polygon/nrfled/nrflpc.brd

## EAGLE design nrflpc.brd (2013-02-13)

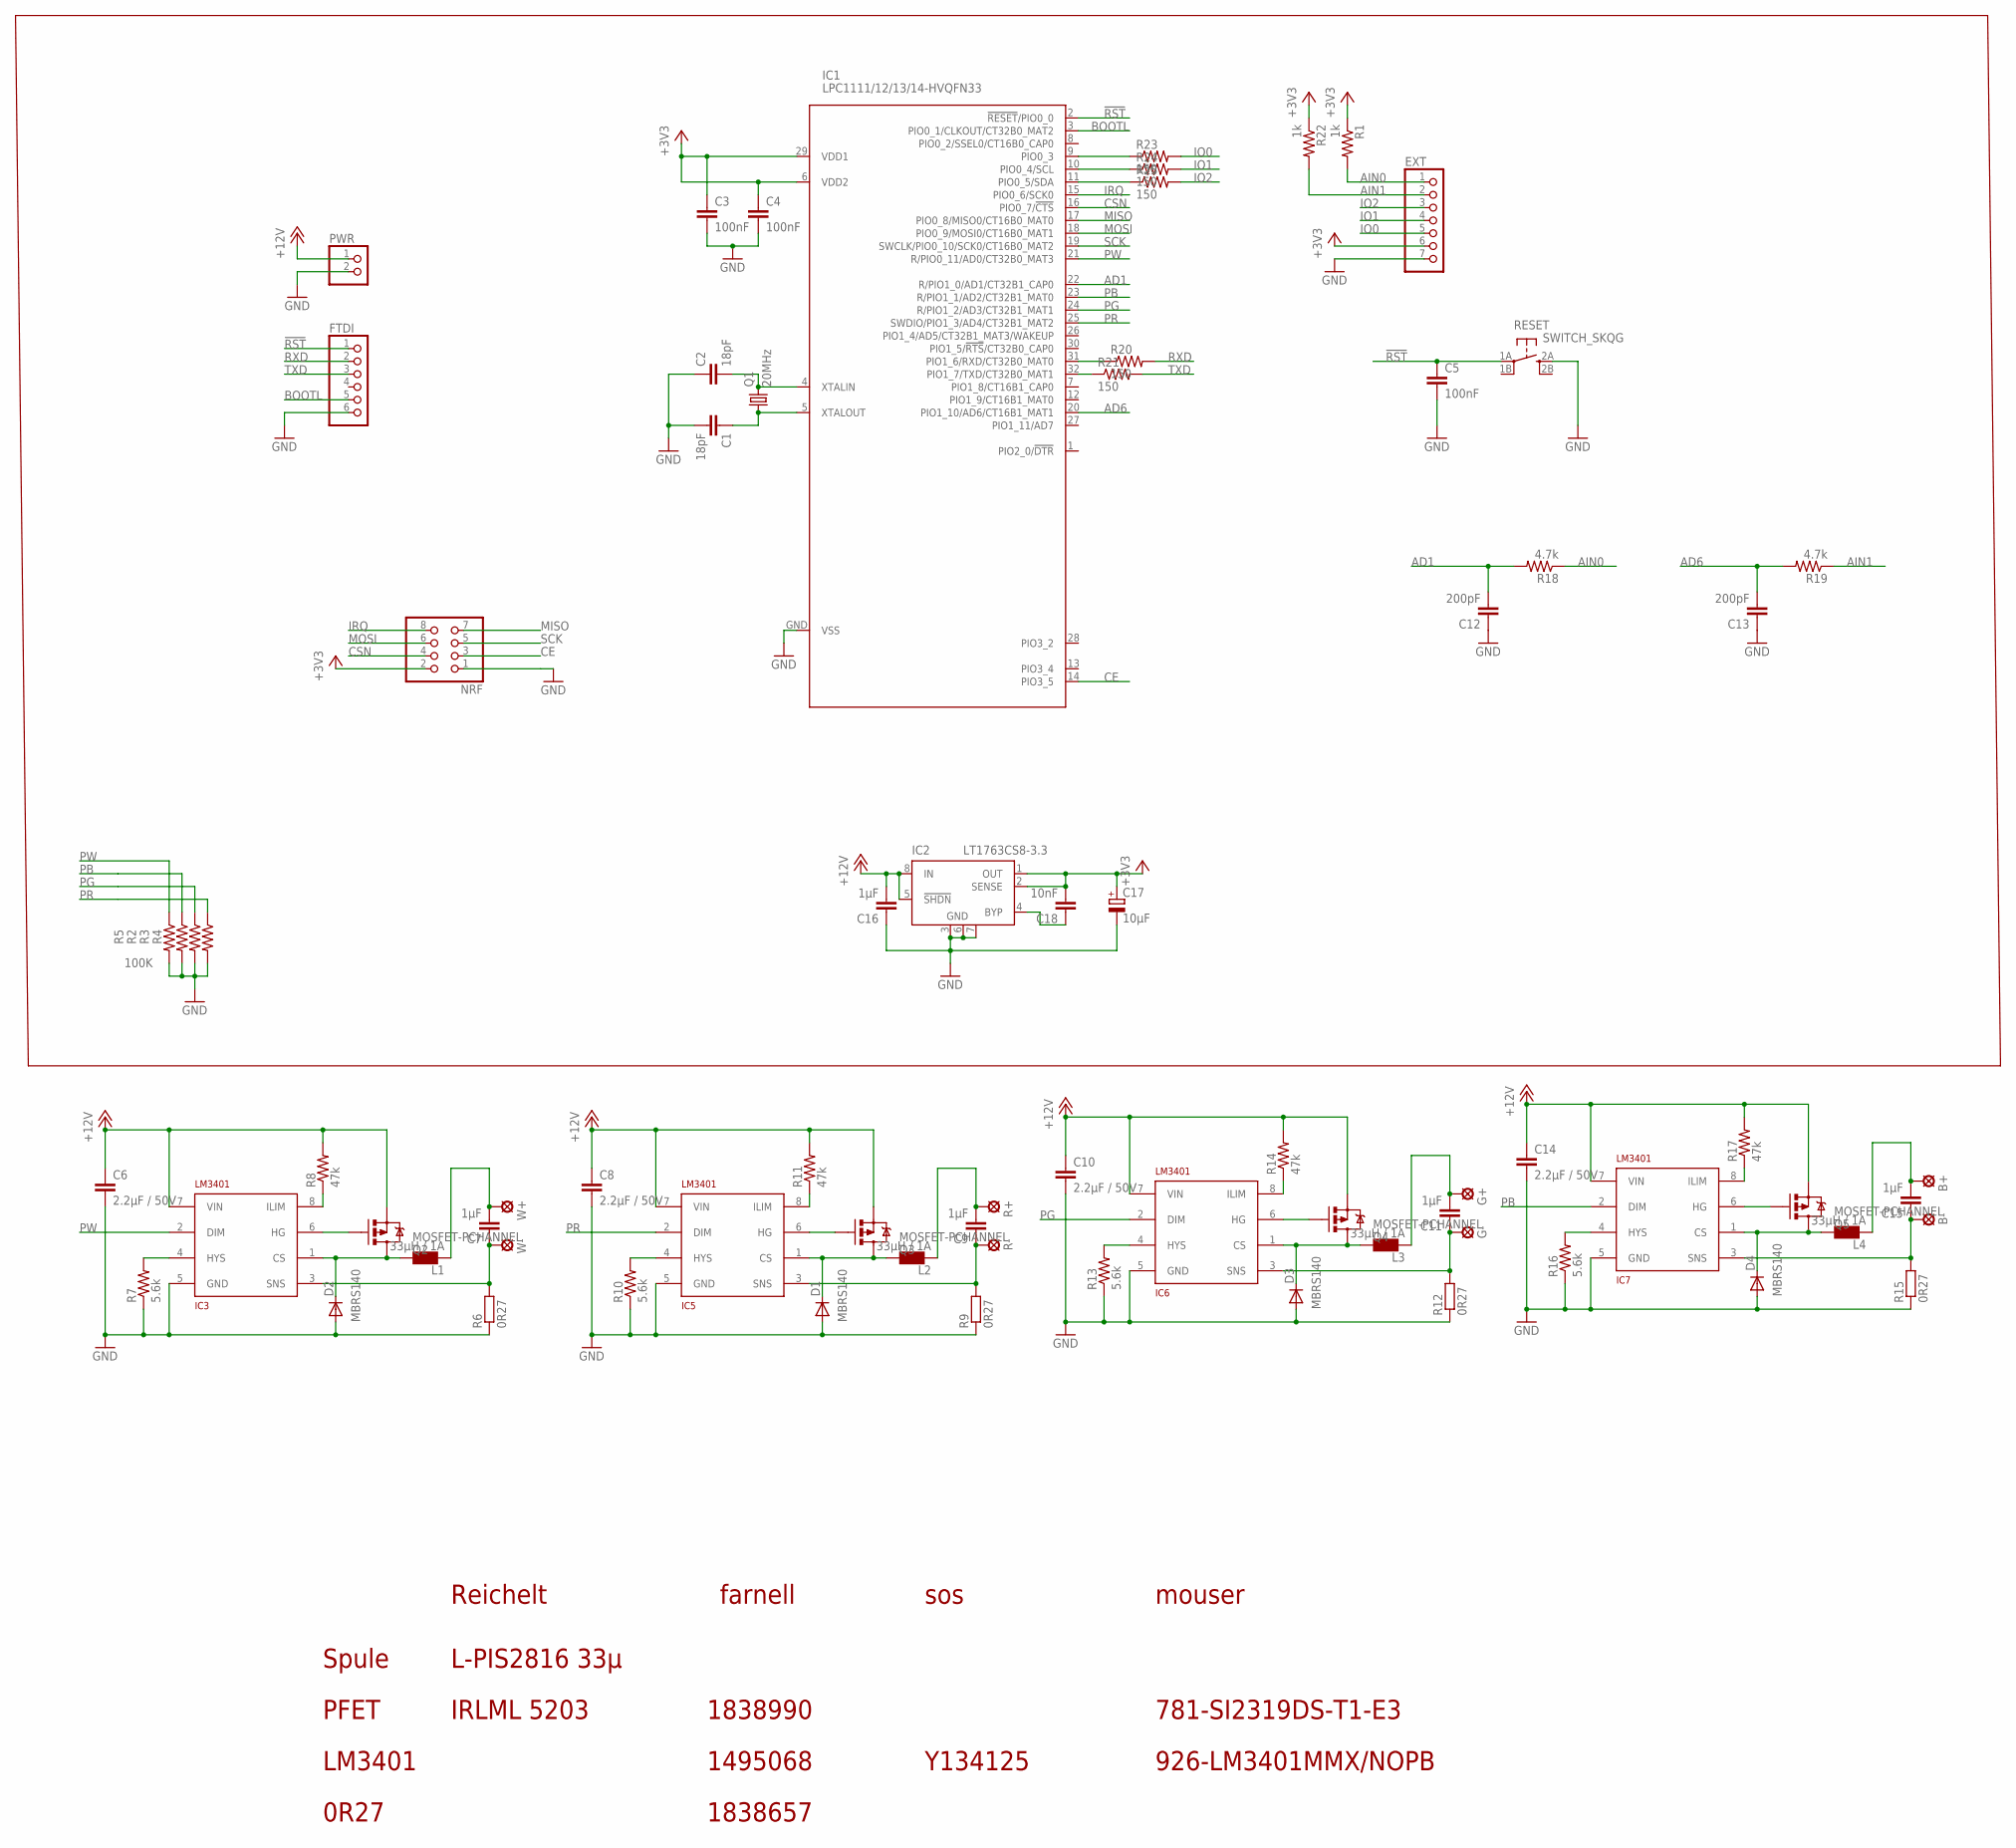
[picture p1: schematic nrflpc.sch]

Parts:
B+: SE14
B-: SE14
C1, C2: 18pF; 0402-CAP
C3, C4, C5: 100nF; 0402-CAP
C6, C8, C10, C14: 2.2µF / 50V; C1210
C7, C9, C11, C15, C16: 1µF; 0805
C12, C13: 200pF; 0402-CAP
C17: 10µF; SMC_A
C18: 10nF; 0402-CAP
D1, D2, D3, D4: MBRS140; SMB
EXT: PINHD-1X7; 1X07
FTDI: PINHD-1X6; 1X06
G+: SE14
G-: SE14
IC1: LPC1111/12/13/14-HVQFN33; HVQFN33
IC2: LT1763CS8-3.3; SOIC8
IC3, IC5, IC6, IC7: LM3401; MSOP8
L1, L2, L3, L4: 33µH / 1A; PIS2816
NRF: PINHD-2X4; 2X04
PWR: PINHD-1X2; 1X02
Q1: 20MHz; MT
Q2, Q3, Q4, Q5: MOSFET-PCHANNEL; SOT23
R1, R22: 1k; 0402-RES
R2, R3, R4, R5: 100K; 0402-RES
R6, R9, R12, R15: 0R27; R1206
R7, R10, R13, R16: 5.6k; 0805
R8, R11, R14, R17: 47k; 0805
R18, R19: 4.7k; 0402-RES
R20, R21, R23, R24, R25: 150; 0402-RES
R+: SE14
R-: SE14
RESET: SWITCH_SKQG
W+: SE14
W-: SE14

Connections:
!RST: C5.1, FTDI.1, IC1.2 (!RESET!/PIO0_0), RESET.1A
+3V3: C3.1, C4.1, C17.+, C18.2, EXT.6, IC1.6 (VDD2), IC1.29 (VDD1), IC2.1 (OUT), IC2.2 (SENSE), NRF.2, R1.1, R22.1
+12V: C6.1, C8.1, C10.1, C14.1, C16.2, IC2.5 (!SHDN), IC2.8 (IN), IC3.7 (VIN), IC5.7 (VIN), IC6.7 (VIN), IC7.7 (VIN), PWR.1, Q2.2 (S), Q3.2 (S), Q4.2 (S), Q5.2 (S), R8.2, R11.2, R14.2, R17.2
AD1: C12.2, IC1.22 (R/PIO1_0/AD1/CT32B1_CAP0), R18.2
AD6: C13.2, IC1.20 (PIO1_10/AD6/CT16B1_MAT1), R19.2
AIN0: EXT.1, R1.2, R18.1
AIN1: EXT.2, R19.1, R22.2
BOOTL: FTDI.5, IC1.3 (PIO0_1/CLKOUT/CT32B0_MAT2)
CE: IC1.14 (PIO3_5), NRF.3
CSN: IC1.16 (PIO0_7/!CTS!), NRF.4
GND: C1.2, C2.1, C3.2, C4.2, C5.2, C6.2, C8.2, C10.2, C12.1, C13.1, C14.2, C16.1, C17.-, D1.A, D2.A, D3.A, D4.A, EXT.7, FTDI.6, IC1.GND (VSS), IC2.3 (GND), IC2.6 (GND), IC2.7 (GND), IC3.5 (GND), IC5.5 (GND), IC6.5 (GND), IC7.5 (GND), NRF.1, PWR.2, R2.2, R3.2, R4.2, R5.2, R6.1, R7.1, R9.1, R10.1, R12.1, R13.1, R15.1, R16.1, RESET.2A
IO0: EXT.5, R23.2
IO1: EXT.4, R24.2
IO2: EXT.3, R25.2
IRQ: IC1.15 (PIO0_6/SCK0), NRF.8
MISO: IC1.17 (PIO0_8/MISO0/CT16B0_MAT0), NRF.7
MOSI: IC1.18 (PIO0_9/MOSI0/CT16B0_MAT1), NRF.6
unnamed: C7.1, IC3.3 (SNS), R6.2, W-.MP
unnamed: C7.2, L1.P$2 (2), W+.MP
unnamed: D2.C, IC3.1 (CS), L1.P$1 (1), Q2.3 (D)
unnamed: C9.1, IC5.3 (SNS), R9.2, R-.MP
unnamed: IC3.4 (HYS), R7.2
unnamed: C9.2, L2.P$2 (2), R+.MP
unnamed: IC3.8 (ILIM), R8.1
unnamed: D1.C, IC5.1 (CS), L2.P$1 (1), Q3.3 (D)
unnamed: IC5.4 (HYS), R10.2
unnamed: IC3.6 (HG), Q2.1 (G)
unnamed: IC5.8 (ILIM), R11.1
unnamed: IC5.6 (HG), Q3.1 (G)
unnamed: C11.1, G-.MP, IC6.3 (SNS), R12.2
unnamed: C11.2, G+.MP, L3.P$2 (2)
unnamed: D3.C, IC6.1 (CS), L3.P$1 (1), Q4.3 (D)
unnamed: IC6.4 (HYS), R13.2
unnamed: IC6.8 (ILIM), R14.1
unnamed: C18.1, IC2.4 (BYP)
unnamed: C2.2, IC1.4 (XTALIN), Q1.3 (2)
unnamed: IC6.6 (HG), Q4.1 (G)
unnamed: B-.MP, C15.1, IC7.3 (SNS), R15.2
unnamed: B+.MP, C15.2, L4.P$2 (2)
unnamed: D4.C, IC7.1 (CS), L4.P$1 (1), Q5.3 (D)
unnamed: IC7.4 (HYS), R16.2
unnamed: IC7.8 (ILIM), R17.1
unnamed: IC7.6 (HG), Q5.1 (G)
unnamed: IC1.31 (PIO1_6/RXD/CT32B0_MAT0), R20.1
unnamed: C1.1, IC1.5 (XTALOUT), Q1.1
unnamed: IC1.32 (PIO1_7/TXD/CT32B0_MAT1), R21.1
unnamed: IC1.9 (PIO0_3), R23.1
unnamed: IC1.10 (PIO0_4/SCL), R24.1
unnamed: IC1.11 (PIO0_5/SDA), R25.1
PB: IC1.23 (R/PIO1_1/AD2/CT32B1_MAT0), IC7.2 (DIM), R2.1
PG: IC1.24 (R/PIO1_2/AD3/CT32B1_MAT1), IC6.2 (DIM), R3.1
PR: IC1.25 (SWDIO/PIO1_3/AD4/CT32B1_MAT2), IC5.2 (DIM), R4.1
PW: IC1.21 (R/PIO0_11/AD0/CT32B0_MAT3), IC3.2 (DIM), R5.1
RXD: FTDI.2, R20.2
SCK: IC1.19 (SWCLK/PIO0_10/SCK0/CT16B0_MAT2), NRF.5
TXD: FTDI.3, R21.2

Notes on the sheet:
Reichelt
Spule
L-PIS2816 33µ
PFET
LM3401
farnell
0R27
1838990
1838657
1495068
Y134125
sos
mouser
781-SI2319DS-T1-E3
926-LM3401MMX/NOPB
IRLML 5203

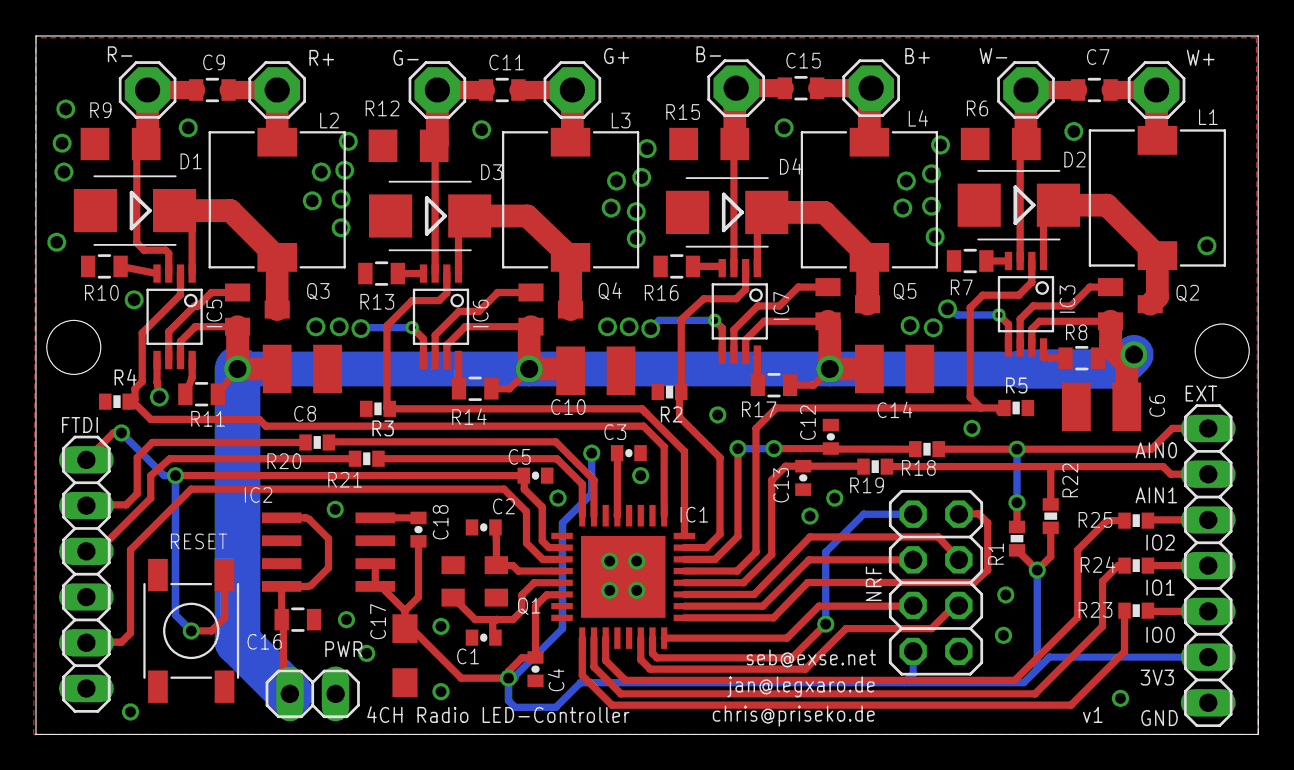
[picture p2: board nrflpc.brd from above]

Board: 2 copper layers, 67.9 x 38.8 mm, 75 parts (0 on the bottom side), 56 nets.
