polygon/nrfled/nrfctl.brd

## EAGLE design nrfctl.brd (2013-01-21)

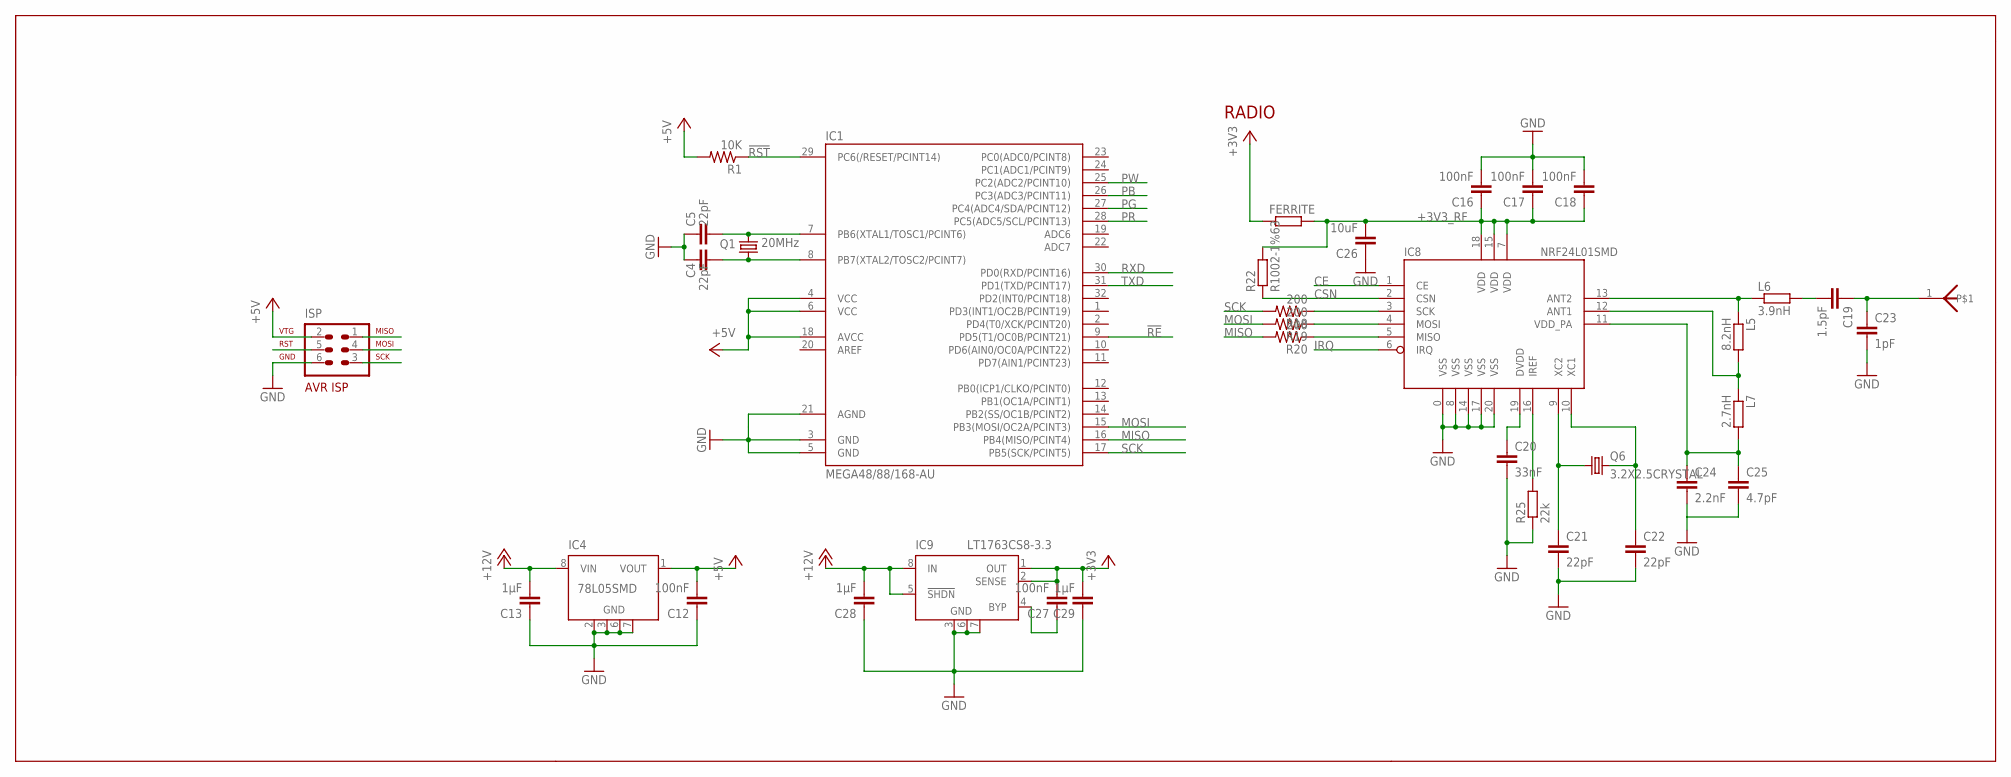
[picture p3: schematic nrfctl.sch]

Parts:
ANT: CHIPANTENNA
C4, C5: 22pF; 0402-CAP
C12, C27: 100nF; 0402-CAP
C13, C28, C29: 1µF; 0805
C16, C17, C18: 100nF; C0402K
C19: 1.5pF; C0402K
C20: 33nF; C0402K
C21, C22: 22pF; C0402K
C23: 1pF; C0402K
C24: 2.2nF; C0402K
C25: 4.7pF; C0402K
C26: 10uF; C0805K
FERRITE: R-EU_R0805; R0805
IC1: MEGA48/88/168-AU; TQFP32-08
IC4: 78L05SMD; SO08
IC8: NRF24L01SMD; QFN20
IC9: LT1763CS8-3.3; SOIC8
ISP: AVR-ISP-6
L5: 8.2nH; R0402
L6: 3.9nH; R0402
L7: 2.7nH; R0402
Q1: 20MHz; X22
Q6: 3.2X2.5CRYSTAL; CRYSTAL3.2X2.5
R1: 10K; 0402-RES
R18, R19, R20: 200; 0402-RES
R22: R1002-1%63; R0603
R25: 22k; R0603

Connections:
!RE: IC1.9 (PD5(T1/OC0B/PCINT21))
!RST: IC1.29 (PC6(/RESET/PCINT14)), ISP.5, R1.1
+3V3: C27.2, C29.2, FERRITE.1, IC9.1 (OUT), IC9.2 (SENSE)
+3V3_RF: C16.1, C17.1, C18.1, C26.2, FERRITE.2, IC8.7 (VDD), IC8.15 (VDD), IC8.18 (VDD), R22.2
+5V: C12.2, IC1.4 (VCC), IC1.6 (VCC), IC1.18 (AVCC), IC4.1 (VOUT), ISP.2, R1.2
+12V: C13.2, C28.2, IC4.8 (VIN), IC9.5 (!SHDN), IC9.8 (IN)
CE: IC8.1 (CE)
CSN: IC8.2 (CSN), R22.1
GND: C4.1, C5.1, C12.1, C13.1, C16.2, C17.2, C18.2, C20.2, C21.2, C22.2, C23.2, C24.2, C25.2, C26.1, C28.1, C29.1, IC1.3 (GND), IC1.5 (GND), IC1.21 (AGND), IC4.2 (GND), IC4.3 (GND), IC4.6 (GND), IC4.7 (GND), IC8.0 (VSS), IC8.8 (VSS), IC8.14 (VSS), IC8.17 (VSS), IC8.20 (VSS), IC9.3 (GND), IC9.6 (GND), IC9.7 (GND), ISP.6, R25.1
IRQ: IC8.6 (IRQ)
MISO: IC1.16 (PB4(MISO/PCINT4)), IC8.5 (MISO), ISP.1, R20.1, R20.2
MOSI: IC1.15 (PB3(MOSI/OC2A/PCINT3)), IC8.4 (MOSI), ISP.4, R19.1, R19.2
unnamed: C21.1, IC8.9 (XC2), Q6.1
unnamed: C22.1, IC8.10 (XC1), Q6.3 (2)
unnamed: ANT.1, C19.1, C23.1
unnamed: C27.1, IC9.4 (BYP)
unnamed: C20.1, IC8.19 (DVDD)
unnamed: IC8.16 (IREF), R25.2
unnamed: C24.1, C25.1, IC8.11 (VDD_PA), L7.2
unnamed: IC8.12 (ANT1), L5.2, L7.1
unnamed: IC8.13 (ANT2), L5.1, L6.1
unnamed: C19.2, L6.2
PB: IC1.26 (PC3(ADC3/PCINT11))
PG: IC1.27 (PC4(ADC4/SDA/PCINT12))
PR: IC1.28 (PC5(ADC5/SCL/PCINT13))
PW: IC1.25 (PC2(ADC2/PCINT10))
RXD: IC1.30 (PD0(RXD/PCINT16))
SCK: IC1.17 (PB5(SCK/PCINT5)), IC8.3 (SCK), ISP.3, R18.1, R18.2
TXD: IC1.31 (PD1(TXD/PCINT17))
XTAL1: C5.2, IC1.7 (PB6(XTAL1/TOSC1/PCINT6)), Q1.3 (2)
XTAL2: C4.2, IC1.8 (PB7(XTAL2/TOSC2/PCINT7)), Q1.1

Notes on the sheet:
RADIO

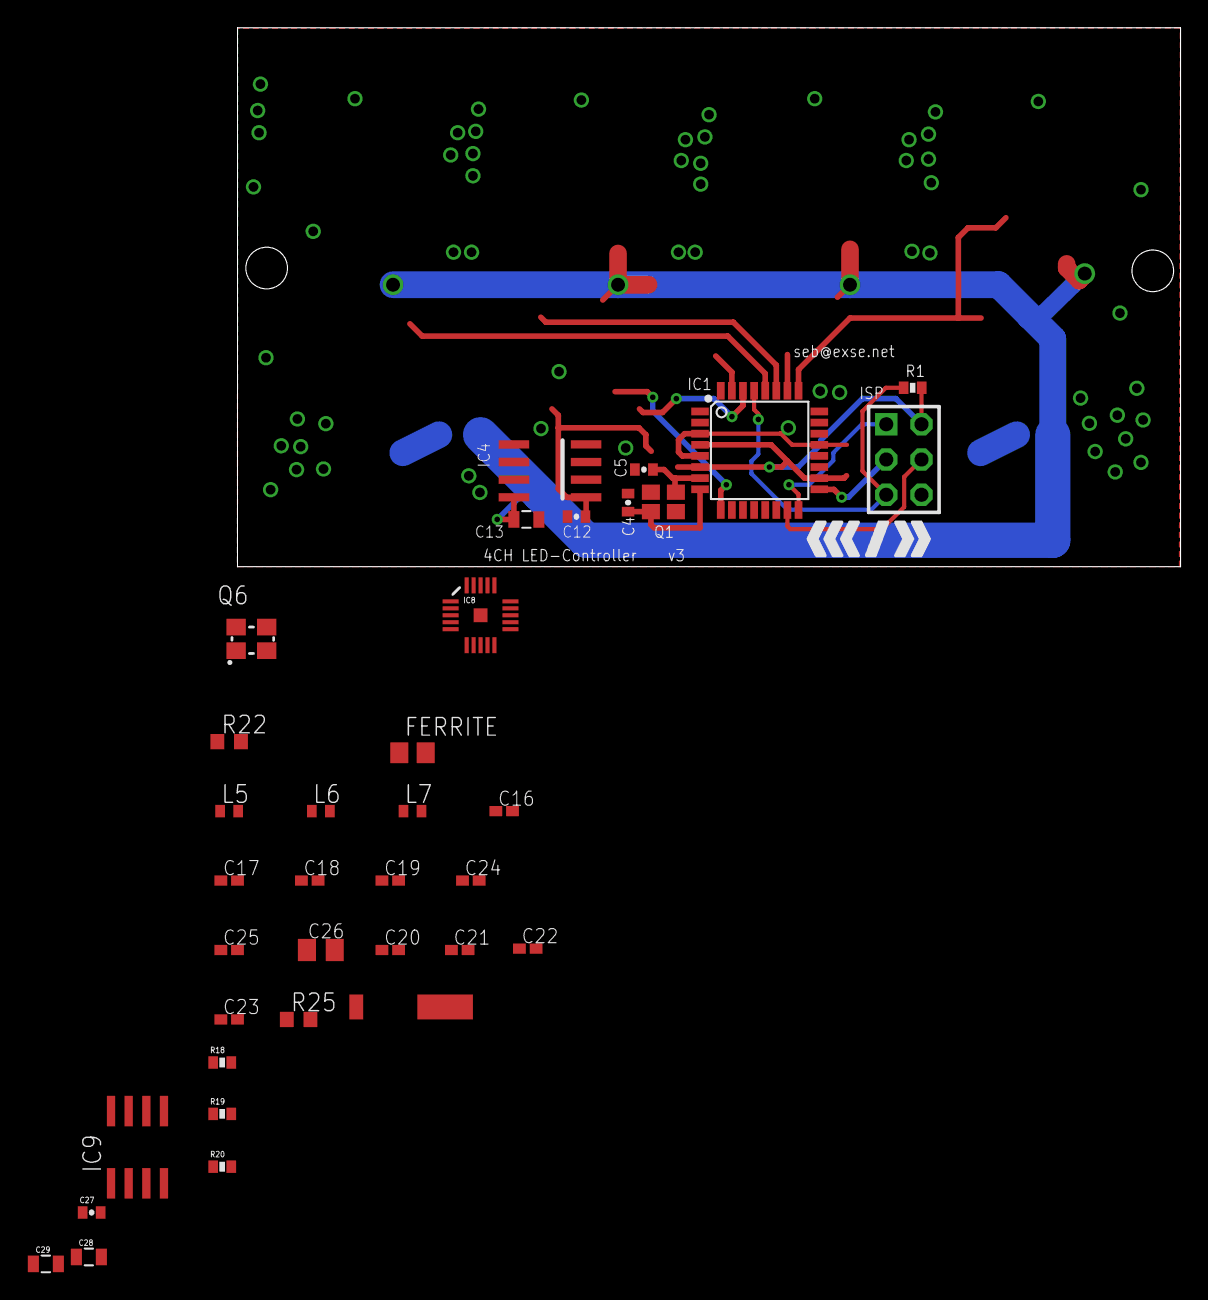
[picture p4: board nrfctl.brd from above]

Board: 2 copper layers, 67.9 x 38.8 mm, 36 parts (0 on the bottom side), 22 nets.
