polygon/nrfled/(commit log)

2013-01-21 Added nrfctrl
    [nrfctl.brd, nrfctl.sch]
2013-01-24 Connectors for NRF-Module and FTDI
    [nrfled.brd, nrfled.sch]
2013-01-24 More connections and extension connector
    [nrfled.brd, nrfled.sch]
2013-01-27 Placement of parts, begin routing
    [nrfled.brd]
2013-01-27 LPC-Version of NRFLED
    [nrflpc.brd, nrflpc.sch]
2013-01-27 Basic LPC circuitry for crystal and power
    [nrflpc.brd, nrflpc.sch]
2013-01-28 Chosen good fitting PWM Pins, Reset circuitry
    [nrflpc.brd, nrflpc.sch]
2013-01-28 Mostly final signal assignment, Starting to place
    [nrflpc.brd, nrflpc.sch]
2013-01-29 ADC input filters
    [nrflpc.brd, nrflpc.sch]
2013-01-29 UART series resistors
    [nrflpc.brd, nrflpc.sch]
2013-01-29 Routing Power supply, in progress
    [nrflpc.brd, nrflpc.sch]
2013-01-30 Removed unnecessary pullups, new 3.3V regulator, begin routing
    [nrflpc.brd, nrflpc.sch]
2013-01-31 Routing Voltage and "left" side (ISP)
    [nrflpc.brd, nrflpc.sch]
2013-01-31 Almost final routing
    [nrflpc.brd, nrflpc.sch]
2013-02-01 Fixed missing GND on IC2
    [nrflpc.brd]
2013-02-01 Fixed even more GND problems
    MORE GND!!!
    [nrflpc.brd]
2013-02-02 updated HVQFN33 package
    [nrflpc.brd, nrflpc.sch]
2013-02-03 Compacting left side
    [nrflpc.brd]
2013-02-03 Compacted right side, reset switch added
    [nrflpc.brd, nrflpc.sch]
2013-02-05 Labels and Makeup
    [nrflpc.brd, nrflpc.sch]
2013-02-08 More silkscreen
    [nrflpc.brd, nrflpc.sch]
